mirnawalid/EmbryoGuard-Pro/EmbryoGuard-Pro/images/wiring/8.jpg

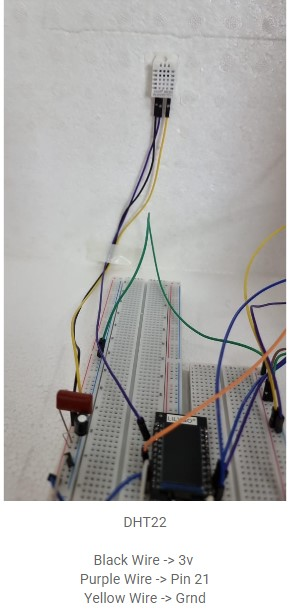
EmbryoGuard-Pro/images/wiring/8.jpg
