mirnawalid/EmbryoGuard-Pro/EmbryoGuard-Pro/images/wiring/11.jpg

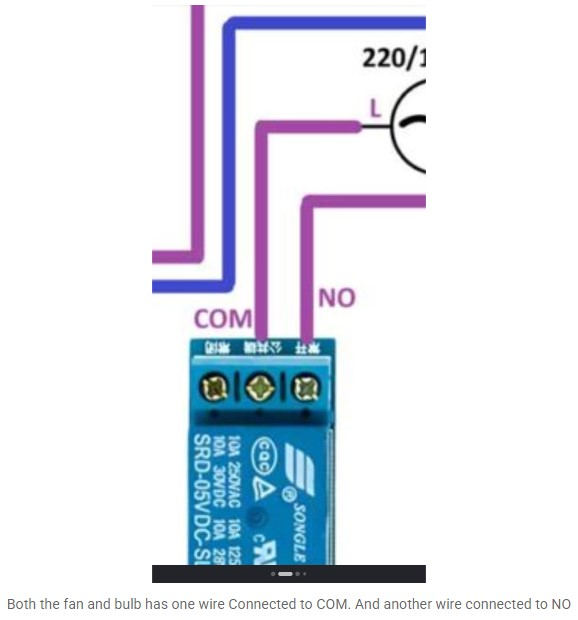
EmbryoGuard-Pro/images/wiring/11.jpg
