mirnawalid/EmbryoGuard-Pro/EmbryoGuard-Pro/images/wiring/1.jpeg

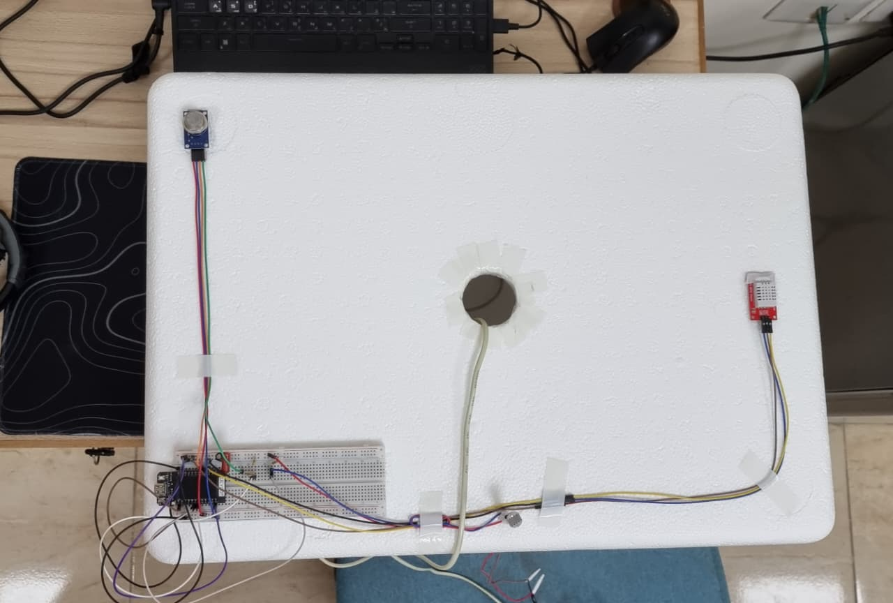
EmbryoGuard-Pro/images/wiring/1.jpeg
