mirnawalid/EmbryoGuard-Pro/EmbryoGuard-Pro/images/wiring/2.jpeg

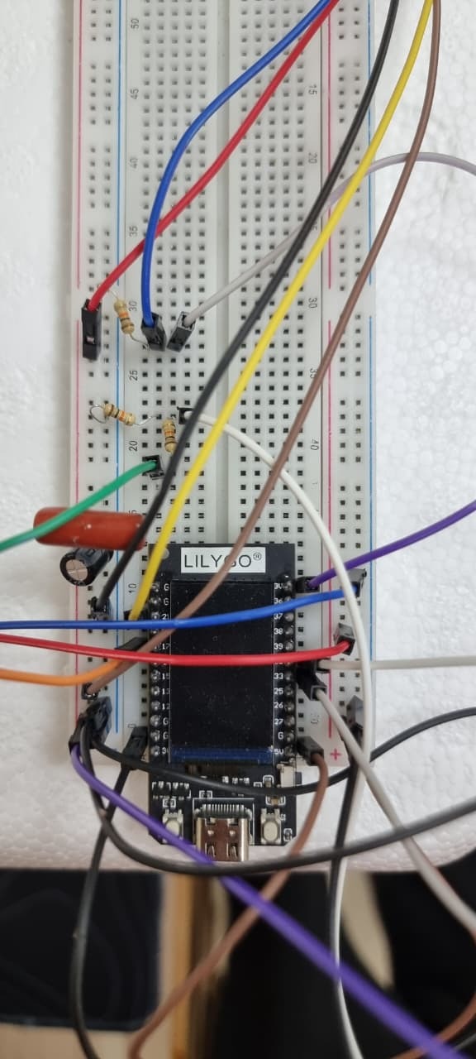
EmbryoGuard-Pro/images/wiring/2.jpeg
