mirnawalid/EmbryoGuard-Pro/EmbryoGuard-Pro/images/wiring/3.jpg

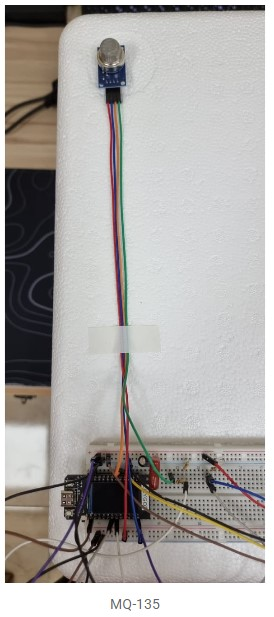
EmbryoGuard-Pro/images/wiring/3.jpg
