mirnawalid/EmbryoGuard-Pro/EmbryoGuard-Pro/images/wiring/4.jpg

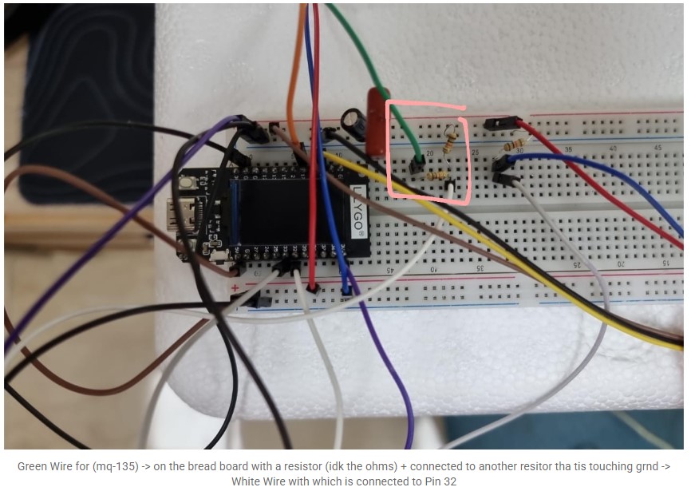
EmbryoGuard-Pro/images/wiring/4.jpg
