mirnawalid/EmbryoGuard-Pro/EmbryoGuard-Pro/images/wiring/5.jpg

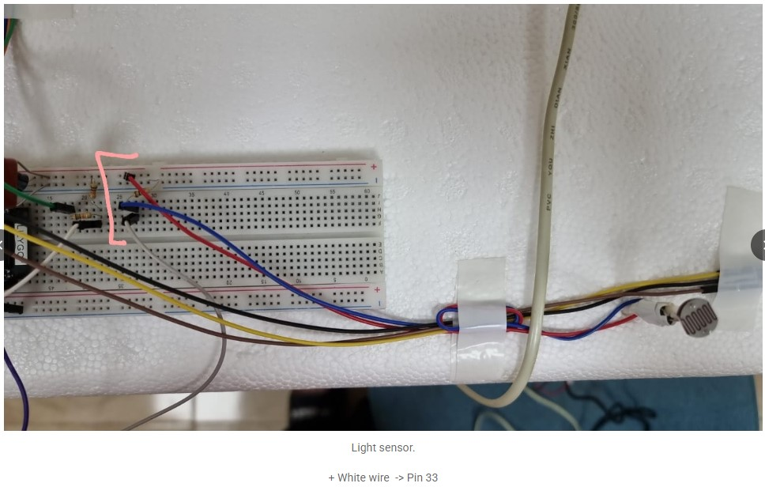
EmbryoGuard-Pro/images/wiring/5.jpg
