mirnawalid/EmbryoGuard-Pro/EmbryoGuard-Pro/images/wiring/6.jpeg

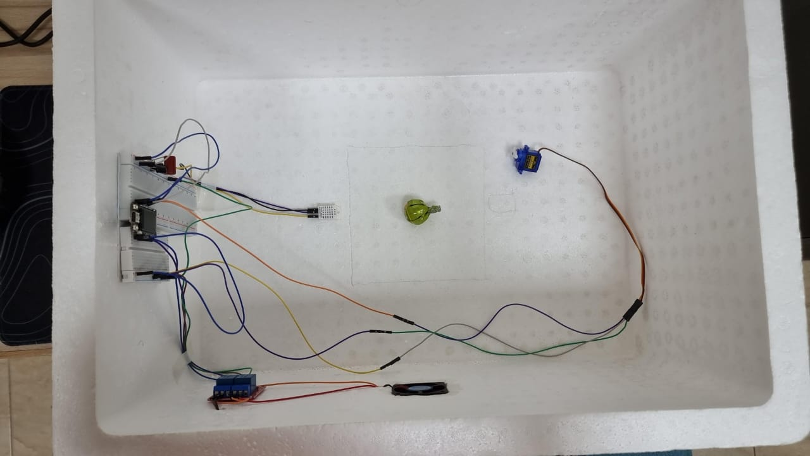
EmbryoGuard-Pro/images/wiring/6.jpeg
