mirnawalid/EmbryoGuard-Pro/EmbryoGuard-Pro/images/wiring/7.jpeg

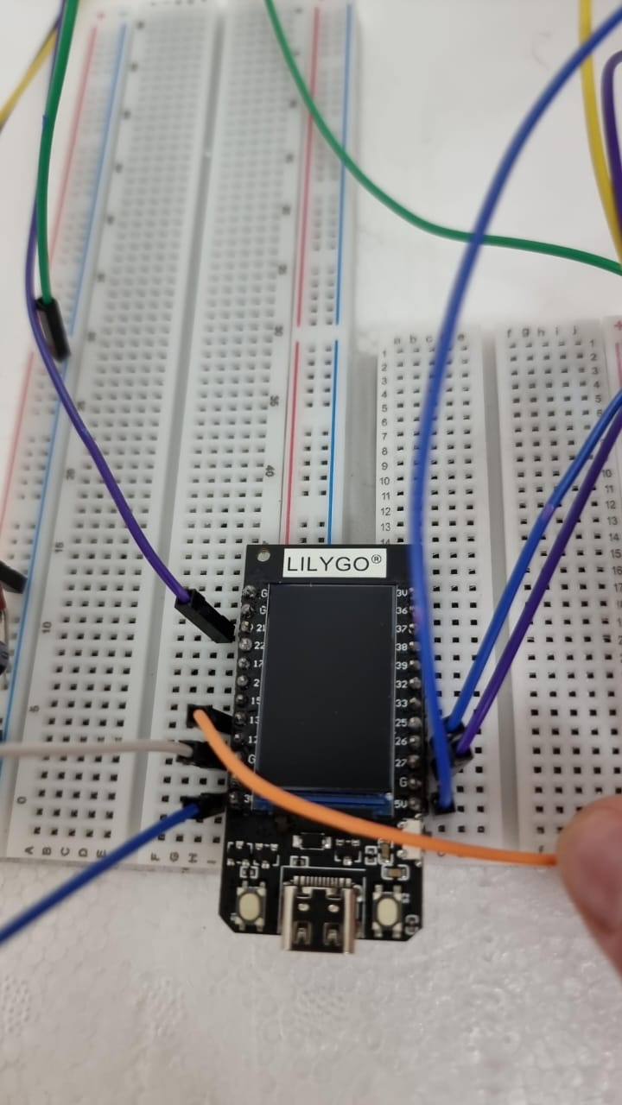
EmbryoGuard-Pro/images/wiring/7.jpeg
