mirnawalid/EmbryoGuard-Pro/EmbryoGuard-Pro/images/wiring/9.jpg

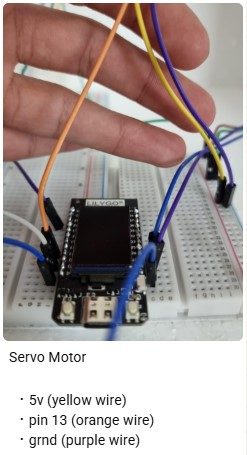
EmbryoGuard-Pro/images/wiring/9.jpg
