mirnawalid/EmbryoGuard-Pro/EmbryoGuard-Pro/images/wiring/10.jpg

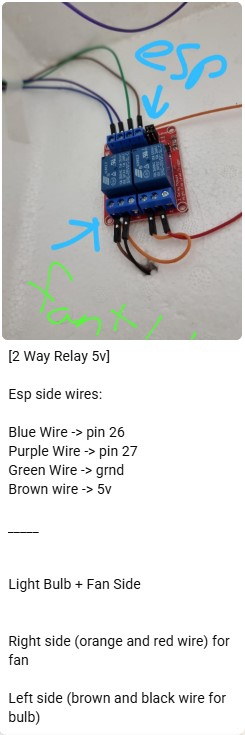
EmbryoGuard-Pro/images/wiring/10.jpg
