mirnawalid/EmbryoGuard-Pro/EmbryoGuard-Pro/images/wiring/12.jpg

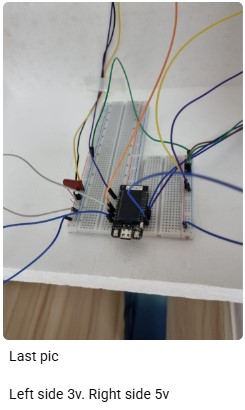
EmbryoGuard-Pro/images/wiring/12.jpg
