mirnawalid/EmbryoGuard-Pro/EmbryoGuard-Pro/images/wiring/13.jpg

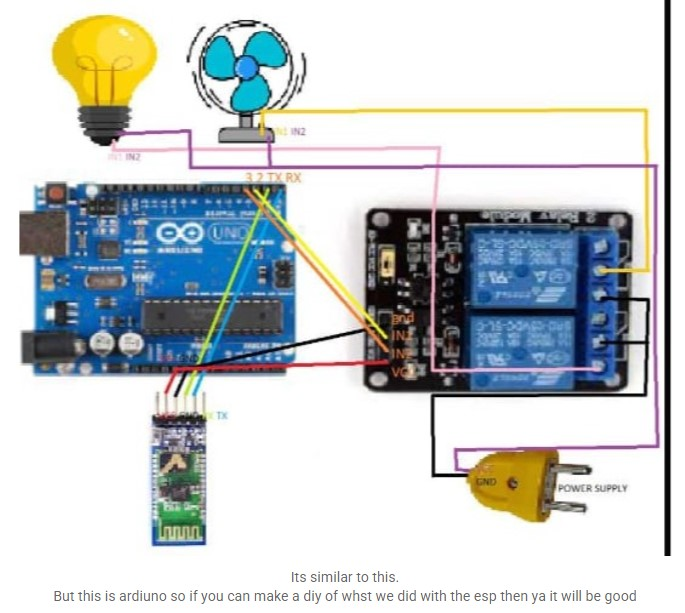
EmbryoGuard-Pro/images/wiring/13.jpg
